LGQWakkk/WKDoubleTXG0/Doc/pcb1.png

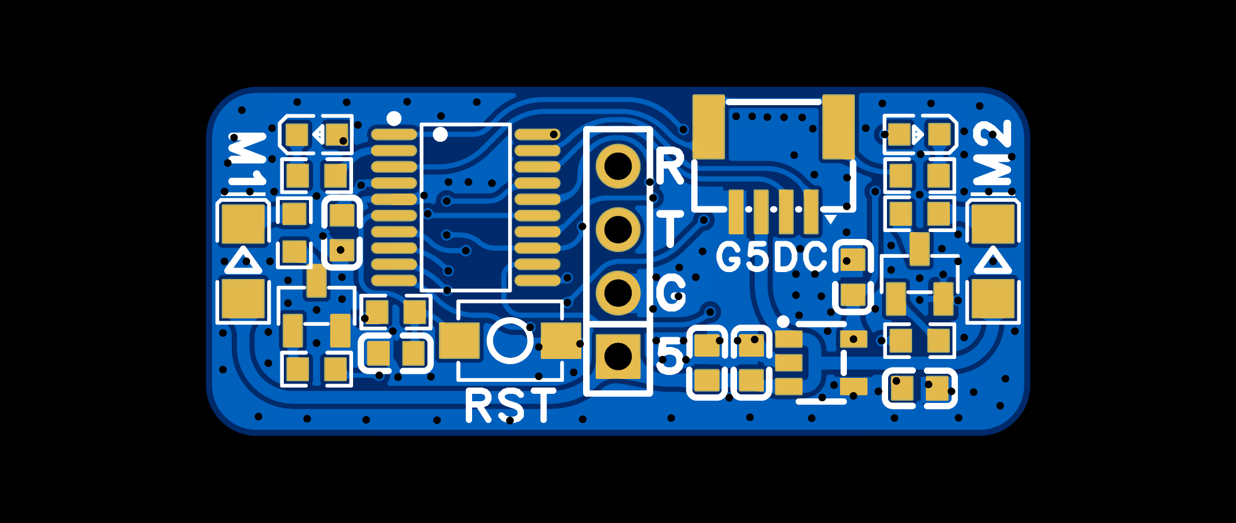
Doc/pcb1.png
