LGQWakkk/WKDoubleTXG0/Doc/pcb2.png

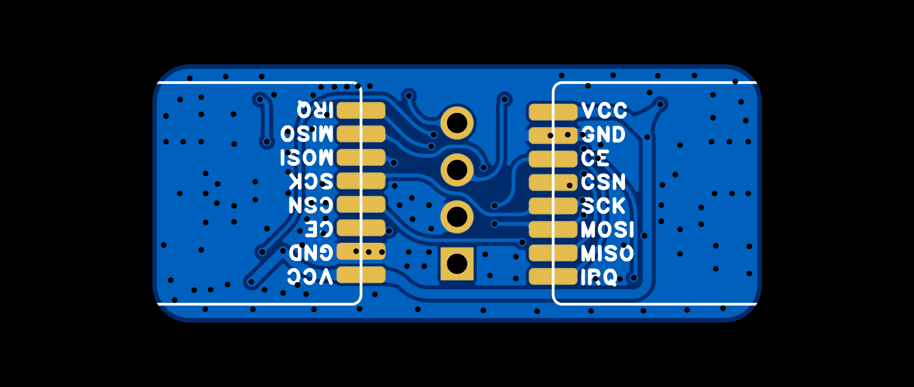
Doc/pcb2.png
