LGQWakkk/WKDoubleTXG0/Doc/BOM.xlsx

No. | Quantity | Comment | Designator | Footprint | Value | Manufacturer Part | Manufacturer | Supplier Part | Supplier
1 | 3 | 100nF | C1,C3,C5 | C0603 | 100nF
2 | 3 | 10uF | C2,C4,C8 | C0603 | 10uF
3 | 1 | HDR-F_2.54_1x4P | H1 | HDR-TH_4P-P2.54-V-F |  |  |  | C2718488
4 | 2 | XL-3216SURC | LED1,LED2 | LED1206-R-RD_RED |  | XL-3216SURC | XINGLIGHT(成兴光) | C965822 | LCSC
5 | 2 | LED_0603-R | LED3,LED4 | LED_0603
6 | 2 | SI2302 | Q1,Q2 | SOT-23-3_L2.9-W1.3-P1.90-LS2.4-BR |  | SI2302 | TECH PUBLIC(台舟) | C2841377 | LCSC
7 | 3 | 1K | R5,R10,R11 | R0603 | 1K
8 | 2 | 50 | R6,R8 | R0603 | 50
9 | 2 | 100 | R7,R9 | R0603 | 100
10 | 1 | TS342A2P-WZ | SW1 | SW-SMD_L4.0-W2.9-LS5.0 |  | TS342A2P-WZ | SHOU HAN(首韩) | C557591 | LCSC
11 | 1 | STM32G030F6P6 | U1 | TSSOP-20_L6.5-W4.4-P0.65-LS6.4-BL |  | STM32G030F6P6 | ST(意法半导体) | C724040 | LCSC
12 | 1 | ME6217C33M5G | U27 | SOT-23-5_L3.0-W1.7-P0.95-LS2.8-BR |  | ME6217C33M5G | MICRONE(南京微盟) | C427602 | LCSC
13 | 2 | NF-03 SI24R1 | U28,U29 | NF-03 SI24R1
14 | 1 | ZX-SH1.0-4PWT | U41 | CONN-SMD_4P-P1.00_MEGASTAR_ZX-SH1.0-4PWT |  | ZX-SH1.0-4PWT | Megastar(兆星) | C7430446 | LCSC
