LGQWakkk/WKDoubleTXG0/Doc/Schematic.pdf

# STM32G030F6P6

# Double RF

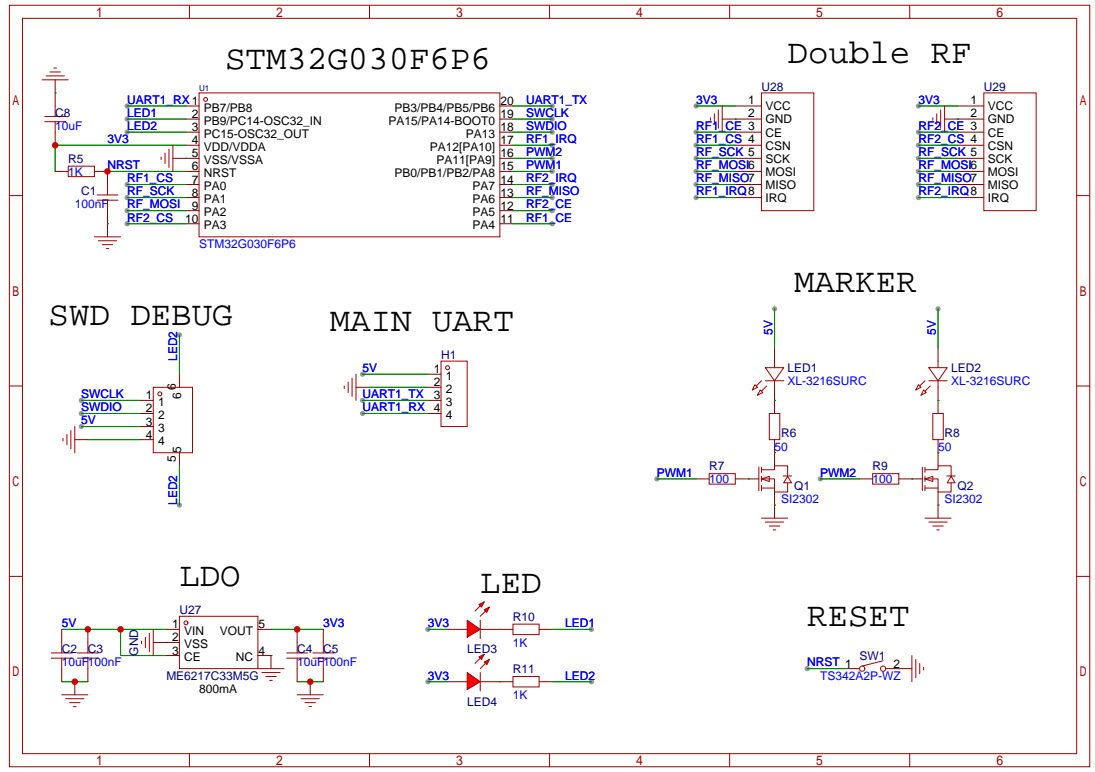
[picture p4: page 1]
