LGQWakkk/WKDoubleTXG0/(list of files, drawings)

Other design files:
Doc/WKDoubleTXG0.epro
