LGQWakkk/WKDoubleTXG0/WKDoubleTXG0.ioc

Mcu.UserName=STM32G030F6Px
PA0.GPIO_Label=RF1_CS
PA0.Signal=GPIO_Output
PA1.GPIO_Label=RF_SCK
PA1.Signal=SPI1_SCK
PA13.Signal=SYS_SWDIO
PA14-BOOT0.Signal=SYS_SWCLK
PA2.GPIO_Label=RF_MOSI
PA2.Signal=SPI1_MOSI
PA3.GPIO_Label=RF2_CS
PA3.Signal=GPIO_Output
PA4.GPIO_Label=RF1_CE
PA4.Signal=GPIO_Output
PA5.GPIO_Label=RF2_CE
PA5.Signal=GPIO_Output
PA6.GPIO_Label=RF_MISO
PA6.Signal=SPI1_MISO
PA7.GPIO_Label=RF2_IRQ
PA7.Signal=GPIO_Input
PA8.GPIO_Label=PWM1
PA8.Signal=S_TIM1_CH1
PB6.Signal=USART1_TX
PB7.Signal=USART1_RX
