LGQWakkk/WKDoubleTXG0/Core/Inc/main.h

#define LED1_Pin GPIO_PIN_14
#define LED1_GPIO_Port GPIOC
#define LED2_Pin GPIO_PIN_15
#define LED2_GPIO_Port GPIOC
#define RF1_CS_Pin GPIO_PIN_0
#define RF1_CS_GPIO_Port GPIOA
#define RF_SCK_Pin GPIO_PIN_1
#define RF_SCK_GPIO_Port GPIOA
#define RF_MOSI_Pin GPIO_PIN_2
#define RF_MOSI_GPIO_Port GPIOA
#define RF2_CS_Pin GPIO_PIN_3
#define RF2_CS_GPIO_Port GPIOA
#define RF1_CE_Pin GPIO_PIN_4
#define RF1_CE_GPIO_Port GPIOA
#define RF2_CE_Pin GPIO_PIN_5
#define RF2_CE_GPIO_Port GPIOA
#define RF_MISO_Pin GPIO_PIN_6
#define RF_MISO_GPIO_Port GPIOA
#define RF2_IRQ_Pin GPIO_PIN_7
#define RF2_IRQ_GPIO_Port GPIOA
#define PWM1_Pin GPIO_PIN_8
#define PWM1_GPIO_Port GPIOA
#define PWM2_Pin GPIO_PIN_11
#define PWM2_GPIO_Port GPIOA
#define RF1_IRQ_Pin GPIO_PIN_12
#define RF1_IRQ_GPIO_Port GPIOA
